ciastkolog/UTP_stm32_board/PCB/scheme.png

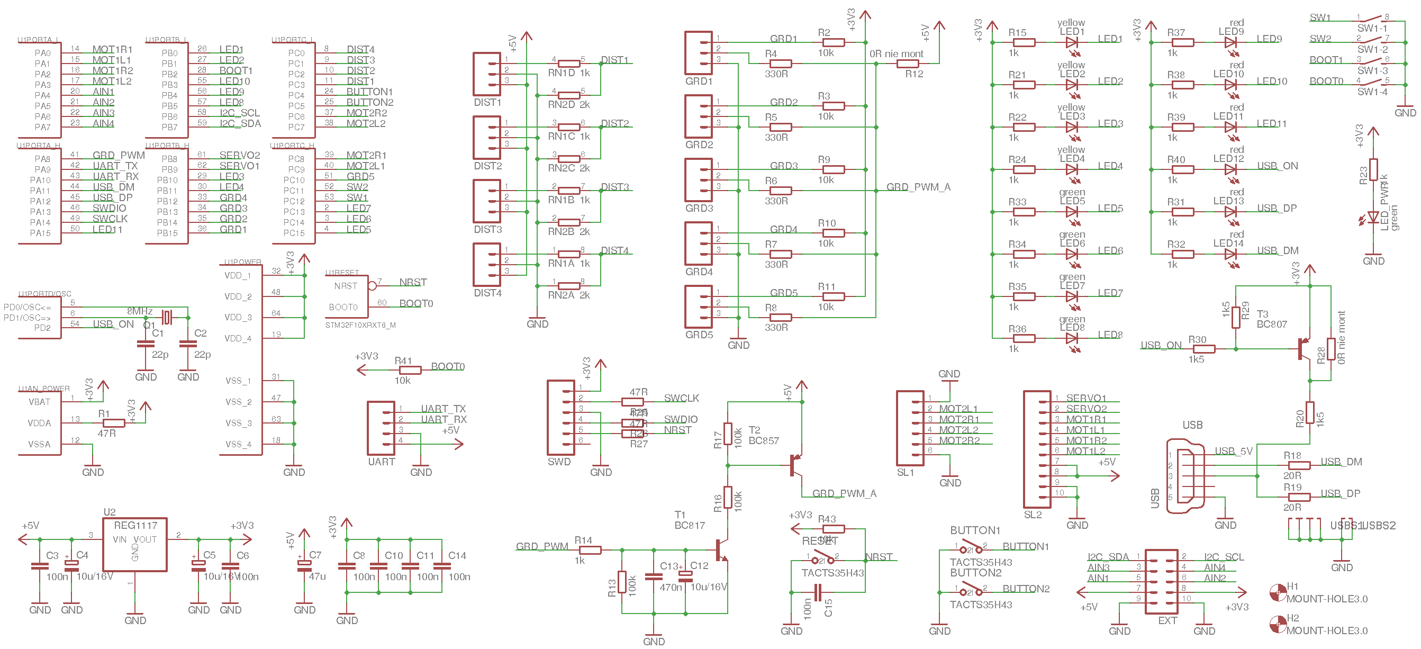
PCB/scheme.png
