ciastkolog/UTP_stm32_board/PCB/sumo_motor_5.brd

## EAGLE design PCB/sumo_motor_5.brd (2017-11-10)

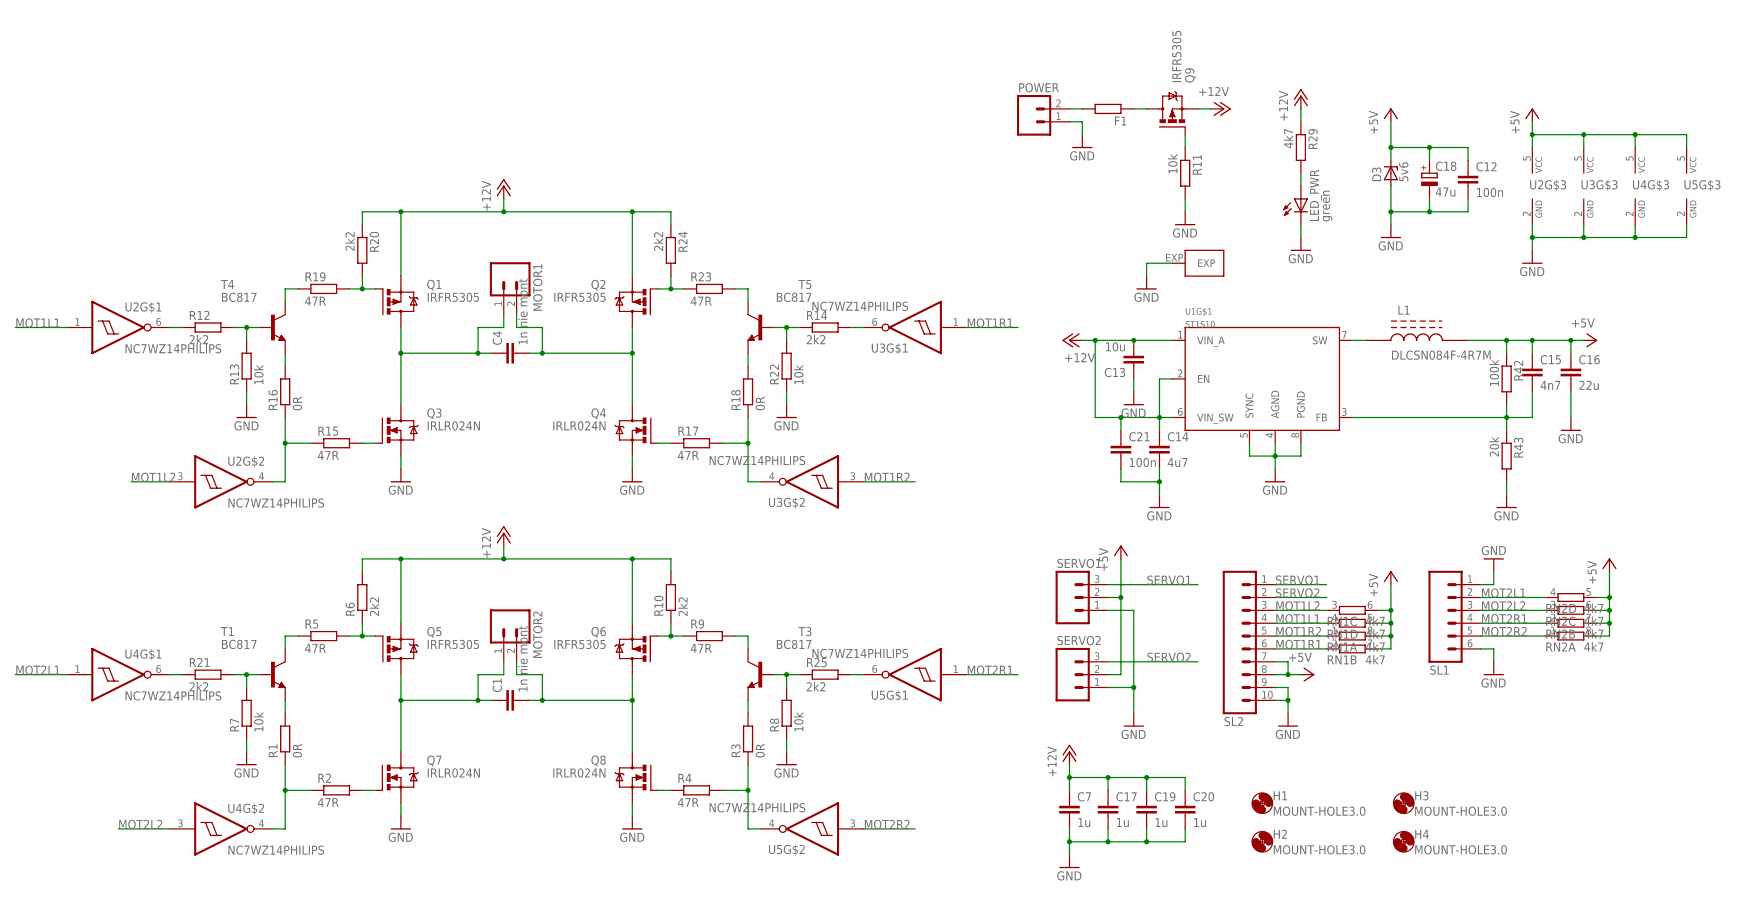
[picture p30: schematic sumo_motor_5.sch]

Parts:
C1, C4: 1n nie mont; C025-025X050
C7, C17, C19, C20: 1u; C0805
C12, C21: 100n; C0805
C13: 10u; C1206K
C14: 4u7; C0805
C15: 4n7; C0805
C16: 22u; C0805
C18: 47u; SMC_B
D3: 5v6; SMB
F1: R-EU_VMTA55; VMTA55
H1, H2, H3, H4: MOUNT-HOLE3.0; 3,0
L1: DLCSN084F-4R7M; CSN084F
LED_PWR: green; SML0805
MOTOR1, MOTOR2: M02; 02P
POWER: M02; 02P
Q1, Q2, Q5, Q6, Q9: IRFR5305; D-PAK_TO252AA
Q3, Q4, Q7, Q8: IRLR024N; D-PAK_TO252AA
R1, R3, R16, R18: 0R; R0603
R2, R4, R5, R9, R15, R17, R19, R23: 47R; R0603
R6, R10, R12, R14, R20, R21, R24, R25: 2k2; R0603
R7, R8, R11, R13, R22: 10k; R0603
R29: 4k7; R0603
R42: 100k; R0603
R43: 20k; R0603
RN1, RN2: 4k7; CAT16XXX
SERVO1, SERVO2: M03; 03P
SL1: M06; 06P
SL2: M10; 10P
T1, T3, T4, T5: BC817; SOT23-BEC
U1: ST1S10; HSOP8
U2, U3, U4, U5: NC7WZ14PHILIPS; SOT363_PHILIPS

Connections:
+5V: C12.1, C15.1, C16.1, C18.+, D3.C, L1.2, R42.1, RN1.5 (2), RN1.6 (2), RN1.7 (2), RN1.8 (2), RN2.5 (2), RN2.6 (2), RN2.7 (2), RN2.8 (2), SERVO1.2, SERVO2.2, SL2.7, SL2.8, U2.5 (VCC), U3.5 (VCC), U4.5 (VCC), U5.5 (VCC)
+12V: C7.1, C13.2, C14.1, C17.1, C19.1, C20.1, C21.1, Q1.3 (S), Q2.3 (S), Q5.3 (S), Q6.3 (S), Q9.3 (S), R6.2, R10.2, R20.1, R24.1, R29.1, U1.1 (VIN_A), U1.2 (EN), U1.6 (VIN_SW)
GND: C7.2, C12.2, C13.1, C14.2, C16.2, C17.2, C18.-, C19.2, C20.2, C21.2, D3.A, LED_PWR.C, POWER.1, Q3.3 (S), Q4.3 (S), Q7.3 (S), Q8.3 (S), R7.1, R8.1, R11.2, R13.1, R22.1, R43.2, SERVO1.1, SERVO2.1, SL1.1, SL1.6, SL2.9, SL2.10, U1.4 (AGND), U1.5 (SYNC), U1.8 (PGND), U1.EXP, U2.2 (GND), U3.2 (GND), U4.2 (GND), U5.2 (GND)
MOT1L1: RN1.4 (1), SL2.4, U2.1 (I)
MOT1L2: RN1.3 (1), SL2.3, U2.3 (I)
MOT1R1: RN1.2 (1), SL2.6, U3.1 (I)
MOT1R2: RN1.1, SL2.5, U3.3 (I)
MOT2L1: RN2.4 (1), SL1.2, U4.1 (I)
MOT2L2: RN2.3 (1), SL1.3, U4.3 (I)
MOT2R1: RN2.2 (1), SL1.4, U5.1 (I)
MOT2R2: RN2.1, SL1.5, U5.3 (I)
unnamed: R5.1, T1.C
unnamed: C1.1, MOTOR2.1, Q5.4 (D), Q7.4 (D)
unnamed: C1.2, MOTOR2.2, Q6.4 (D), Q8.4 (D)
unnamed: R19.1, T4.C
unnamed: R7.2, R21.2, T1.B
unnamed: Q5.1 (G), R5.2, R6.1
unnamed: Q6.1 (G), R9.1, R10.1
unnamed: R21.1, U4.6 (O)
unnamed: R1.2, T1.E
unnamed: R1.1, R2.1, U4.4 (O)
unnamed: Q3.1 (G), R15.2
unnamed: R16.2, T4.E
unnamed: Q7.1 (G), R2.2
unnamed: C4.1, MOTOR1.1, Q1.4 (D), Q3.4 (D)
unnamed: C4.2, MOTOR1.2, Q2.4 (D), Q4.4 (D)
unnamed: Q1.1 (G), R19.2, R20.2
unnamed: Q2.1 (G), R23.1, R24.2
unnamed: Q4.1 (G), R17.1
unnamed: R17.2, R18.1, U3.4 (O)
unnamed: R12.2, R13.2, T4.B
unnamed: R12.1, U2.6 (O)
unnamed: R18.2, T5.E
unnamed: R14.2, U3.6 (O)
unnamed: F1.2, POWER.2
unnamed: F1.1, Q9.4 (D)
unnamed: LED_PWR.A, R29.2
unnamed: Q8.1 (G), R4.1
unnamed: R3.1, R4.2, U5.4 (O)
unnamed: R3.2, T3.E
unnamed: R9.2, T3.C
unnamed: R8.2, R25.1, T3.B
unnamed: R25.2, U5.6 (O)
unnamed: L1.1, U1.7 (SW)
unnamed: C15.2, R42.2, R43.1, U1.3 (FB)
unnamed: Q9.1 (G), R11.1
unnamed: R23.2, T5.C
unnamed: R15.1, R16.1, U2.4 (O)
unnamed: R14.1, R22.2, T5.B
SERVO1: SERVO1.3, SL2.1
SERVO2: SERVO2.3, SL2.2

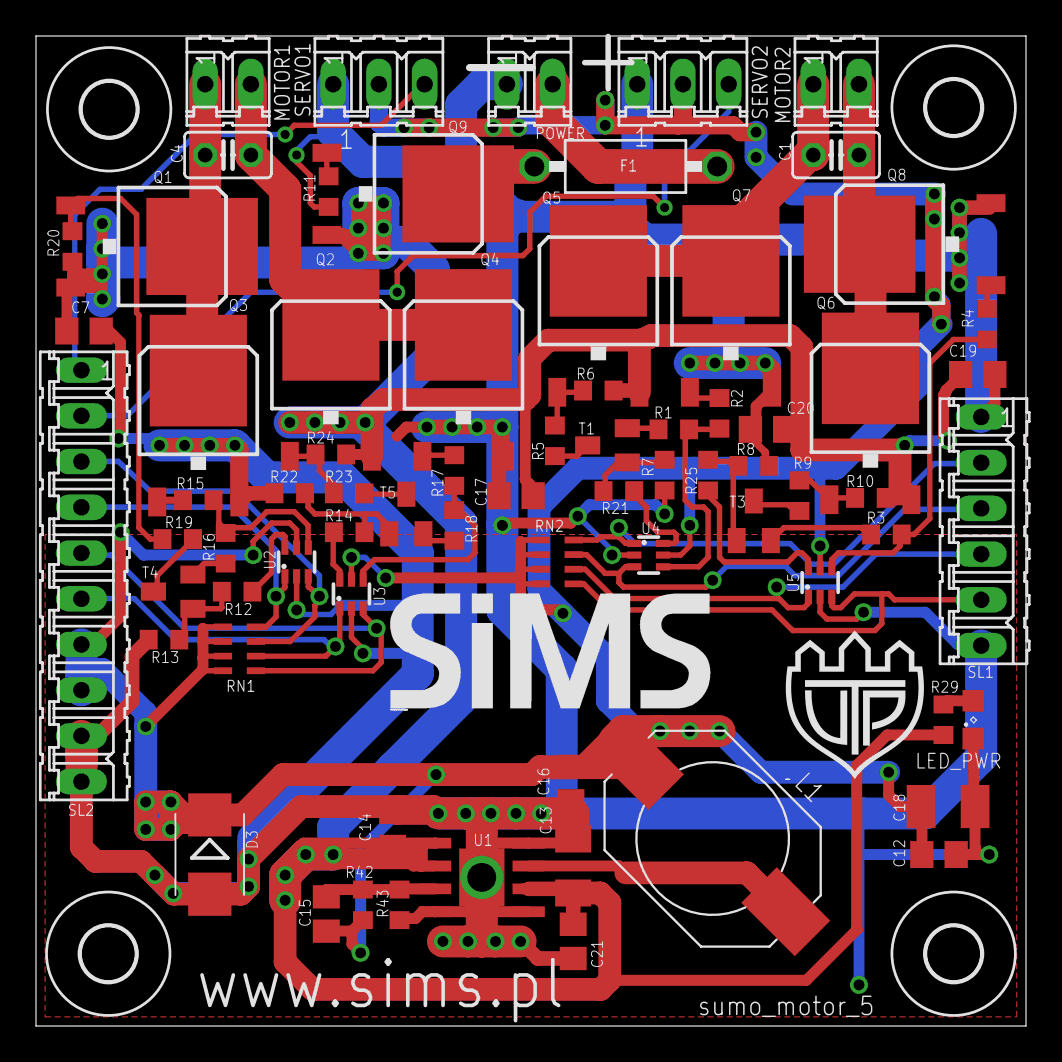
[picture p31: board sumo_motor_5.brd from above]

Board: 2 copper layers, 55.0 x 55.0 mm, 78 parts (0 on the bottom side), 51 nets.

Other parts of the board:
U$1: SIMS_07
U$2: UTP_016
