ciastkolog/UTP_stm32_board/PCB/sumo_base_5.brd

## EAGLE design PCB/sumo_base_5.brd (2017-11-10)

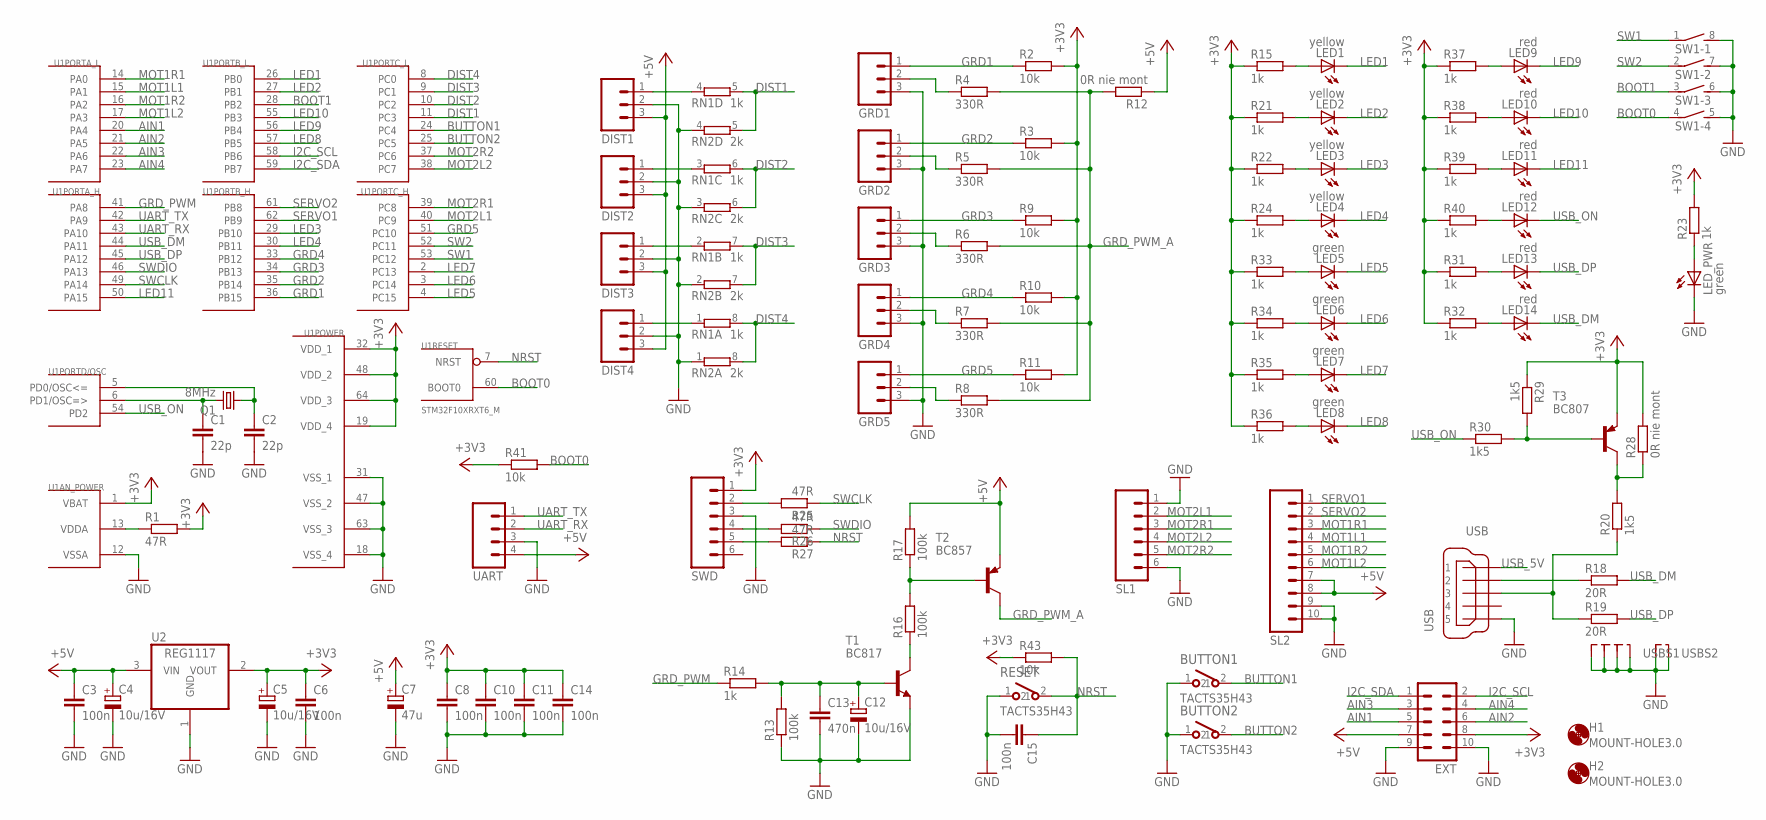
[picture p32: schematic sumo_base_5.sch]

Parts:
BUTTON1, BUTTON2: TACTS35H43
C1, C2: 22p; C0603
C3, C6, C8, C10, C11, C14, C15: 100n; C0603
C4, C5, C12: 10u/16V; SMC_A
C7: 47u; SMC_B
C13: 470n; C0603
DIST1, DIST2, DIST3, DIST4: M03; 03P
EXT: MA05-2
GRD1, GRD2, GRD3, GRD4, GRD5: M03; 03P
H1, H2: MOUNT-HOLE3.0; 3,0
LED1, LED2, LED3, LED4: yellow; SML0805
LED5, LED6, LED7, LED8: green; SML0805
LED9, LED10, LED11, LED12, LED13, LED14: red; SML0805
LED_PWR: green; SML0805
Q1: 8MHz; HC49/S
R1, R25, R26, R27: 47R; R0603
R2, R3, R9, R10, R11, R41, R43: 10k; R0603
R4, R5, R6, R7, R8: 330R; R0603
R12, R28: 0R nie mont; R0603
R13, R16, R17: 100k; R0603
R14, R15, R21, R22, R23, R24, R31, R32, R33, R34, R35, R36, R37, R38, R39, R40: 1k; R0603
R18, R19: 20R; R0603
R20, R29, R30: 1k5; R0603
RESET: TACTS35H43
RN1: 1k; CAT16XXX
RN2: 2k; CAT16XXX
SL1: M06; 06P
SL2: M10; 10P
SW1: DIP04S
SWD: M06; 06P
T1: BC817; SOT23-BEC
T2: BC857; SOT23-BEC
T3: BC807; SOT23-BEC
U1: STM32F10XRXT6_M; FP64E
U2: REG1117; SOT223
UART: M04; 04P
USB: USB; MX47346

Connections:
+3V3: C5.+, C6.1, C8.1, C10.1, C11.1, C14.1, EXT.8, R1.2, R2.2, R3.2, R9.2, R10.2, R11.2, R15.1, R21.1, R22.1, R23.2, R24.1, R28.2, R29.1, R31.1, R32.1, R33.1, R34.1, R35.1, R36.1, R37.1, R38.1, R39.1, R40.1, R41.1, R43.1, SWD.1, T3.E, U1.1 (VBAT), U1.19 (VDD_4), U1.32 (VDD_1), U1.48 (VDD_2), U1.64 (VDD_3), U2.2 (VOUT)
+5V: C3.1, C4.+, C7.+, DIST1.3, DIST2.3, DIST3.3, DIST4.3, EXT.7, R12.1, R17.2, SL2.7, SL2.8, T2.E, U2.3 (VIN), UART.4
AIN1: EXT.5, U1.20 (PA4)
AIN2: EXT.6, U1.21 (PA5)
AIN3: EXT.3, U1.22 (PA6)
AIN4: EXT.4, U1.23 (PA7)
BOOT0: R41.2, SW1.4 (1), U1.60 (BOOT0)
BOOT1: SW1.3 (1), U1.28 (PB2)
BUTTON1: BUTTON1.2, U1.24 (PC4)
BUTTON2: BUTTON2.2, U1.25 (PC5)
DIST1: RN1.5 (2), RN2.5 (2), U1.11 (PC3)
DIST2: RN1.6 (2), RN2.6 (2), U1.10 (PC2)
DIST3: RN1.7 (2), RN2.7 (2), U1.9 (PC1)
DIST4: RN1.8 (2), RN2.8 (2), U1.8 (PC0)
GND: BUTTON1.1, BUTTON2.1, C1.2, C2.2, C3.2, C4.-, C5.-, C6.2, C7.-, C8.2, C10.2, C11.2, C12.-, C13.2, C14.2, C15.2, DIST1.2, DIST2.2, DIST3.2, DIST4.2, EXT.9, EXT.10, GRD1.3, GRD2.3, GRD3.3, GRD4.3, GRD5.3, LED_PWR.C, R13.1, RESET.1, RN2.1, RN2.2 (1), RN2.3 (1), RN2.4 (1), SL1.1, SL1.6, SL2.9, SL2.10, SW1.5 (2), SW1.6 (2), SW1.7 (2), SW1.8 (2), SWD.3, T1.E, U1.12 (VSSA), U1.18 (VSS_4), U1.31 (VSS_1), U1.47 (VSS_2), U1.63 (VSS_3), U2.1 (GND), UART.3, USB.5, USB.M1 (S1), USB.M2 (S2), USB.M3 (S3), USB.M4 (S4), USB.M5 (S1), USB.M6 (S2)
GRD1: GRD1.1, R2.1, U1.36 (PB15)
GRD2: GRD2.1, R3.1, U1.35 (PB14)
GRD3: GRD3.1, R9.1, U1.34 (PB13)
GRD4: GRD4.1, R10.1, U1.33 (PB12)
GRD5: GRD5.1, R11.1, U1.51 (PC10)
GRD_PWM: R14.1, U1.41 (PA8)
GRD_PWM_A: R4.2, R5.2, R6.2, R7.2, R8.2, R12.2, T2.C
I2C_SCL: EXT.2, U1.58 (PB6)
I2C_SDA: EXT.1, U1.59 (PB7)
LED1: LED1.C, U1.26 (PB0)
LED2: LED2.C, U1.27 (PB1)
LED3: LED3.C, U1.29 (PB10)
LED4: LED4.C, U1.30 (PB11)
LED5: LED5.C, U1.4 (PC15)
LED6: LED6.C, U1.3 (PC14)
LED7: LED7.C, U1.2 (PC13)
LED8: LED8.C, U1.57 (PB5)
LED9: LED9.C, U1.56 (PB4)
LED10: LED10.C, U1.55 (PB3)
LED11: LED11.C, U1.50 (PA15)
MOT1L1: SL2.4, U1.15 (PA1)
MOT1L2: SL2.6, U1.17 (PA3)
MOT1R1: SL2.3, U1.14 (PA0)
MOT1R2: SL2.5, U1.16 (PA2)
MOT2L1: SL1.2, U1.40 (PC9)
MOT2L2: SL1.4, U1.38 (PC7)
MOT2R1: SL1.3, U1.39 (PC8)
MOT2R2: SL1.5, U1.37 (PC6)
unnamed: R29.2, R30.2, T3.B
unnamed: R20.2, R28.1, T3.C
unnamed: LED_PWR.A, R23.1
unnamed: LED12.A, R40.2
unnamed: LED13.A, R31.2
unnamed: LED14.A, R32.2
unnamed: R25.2, SWD.2
unnamed: C2.1, Q1.1, U1.5 (PD0/OSC<=)
unnamed: C1.1, Q1.2, U1.6 (PD1/OSC=>)
unnamed: R1.1, U1.13 (VDDA)
unnamed: DIST1.1, RN1.4 (1)
unnamed: GRD3.2, R6.1
unnamed: DIST3.1, RN1.2 (1)
unnamed: DIST2.1, RN1.3 (1)
unnamed: DIST4.1, RN1.1
unnamed: GRD1.2, R4.1
unnamed: GRD2.2, R5.1
unnamed: GRD4.2, R7.1
unnamed: GRD5.2, R8.1
unnamed: C12.+, C13.1, R13.2, R14.2, T1.B
unnamed: LED1.A, R15.2
unnamed: LED2.A, R21.2
unnamed: LED3.A, R22.2
unnamed: LED4.A, R24.2
unnamed: LED5.A, R33.2
unnamed: LED6.A, R34.2
unnamed: LED7.A, R35.2
unnamed: LED8.A, R36.2
unnamed: R16.1, T1.C
unnamed: R16.2, R17.1, T2.B
unnamed: R18.1, USB.2
unnamed: R19.1, R20.1, USB.3
unnamed: LED9.A, R37.2
unnamed: LED10.A, R38.2
unnamed: LED11.A, R39.2
unnamed: R26.2, SWD.4
unnamed: R27.2, SWD.5
NRST: C15.1, R27.1, R43.2, RESET.2, U1.7 (NRST)
SERVO1: SL2.1, U1.62 (PB9)
SERVO2: SL2.2, U1.61 (PB8)
SW1: SW1.1, U1.53 (PC12)
SW2: SW1.2 (1), U1.52 (PC11)
SWCLK: R25.1, U1.49 (PA14)
SWDIO: R26.1, U1.46 (PA13)
UART_RX: U1.43 (PA10), UART.2
UART_TX: U1.42 (PA9), UART.1
USB_5V: USB.1
USB_DM: LED14.C, R18.2, U1.44 (PA11)
USB_DP: LED13.C, R19.2, U1.45 (PA12)
USB_ON: LED12.C, R30.1, U1.54 (PD2)

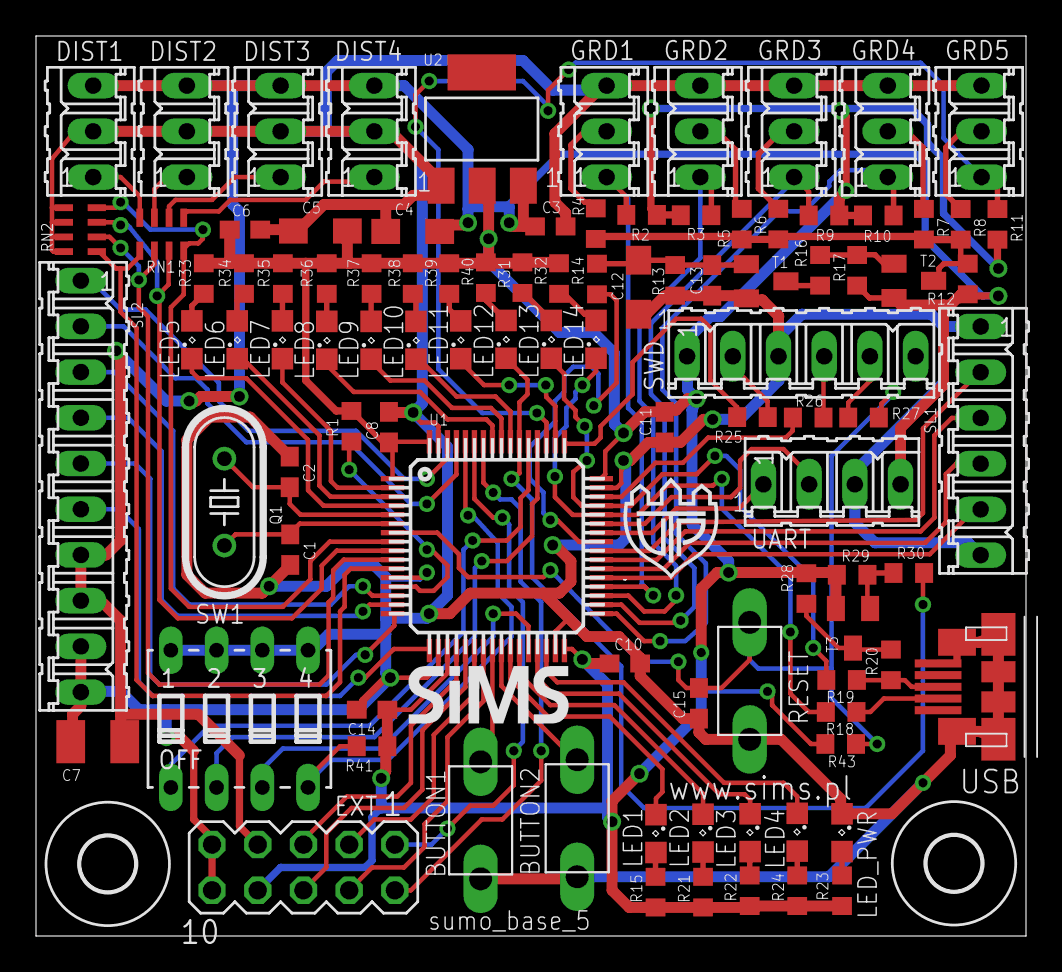
[picture p33: board sumo_base_5.brd from above]

Board: 2 copper layers, 55.0 x 50.0 mm, 102 parts (0 on the bottom side), 92 nets.

Other parts of the board:
U$1: SIMS_035
U$2: UTP_011
