ciastkolog/UTP_stm32_board/code/UTP_stm32_board/Inc/main.h

#define LED7_Pin GPIO_PIN_13
#define LED7_GPIO_Port GPIOC
#define LED6_Pin GPIO_PIN_14
#define LED6_GPIO_Port GPIOC
#define LED5_Pin GPIO_PIN_15
#define LED5_GPIO_Port GPIOC
#define BUTTON1_Pin GPIO_PIN_4
#define BUTTON1_GPIO_Port GPIOC
#define BUTTON2_Pin GPIO_PIN_5
#define BUTTON2_GPIO_Port GPIOC
#define LED1_Pin GPIO_PIN_0
#define LED1_GPIO_Port GPIOB
#define LED2_Pin GPIO_PIN_1
#define LED2_GPIO_Port GPIOB
#define SW3_Pin GPIO_PIN_2
#define SW3_GPIO_Port GPIOB
#define LED3_Pin GPIO_PIN_10
#define LED3_GPIO_Port GPIOB
#define LED4_Pin GPIO_PIN_11
#define LED4_GPIO_Port GPIOB
#define LED11_Pin GPIO_PIN_15
#define LED11_GPIO_Port GPIOA
#define SW2_Pin GPIO_PIN_11
#define SW2_GPIO_Port GPIOC
#define SW1_Pin GPIO_PIN_12
#define SW1_GPIO_Port GPIOC
#define USB_ON_Pin GPIO_PIN_2
#define USB_ON_GPIO_Port GPIOD
#define LED10_Pin GPIO_PIN_3
#define LED10_GPIO_Port GPIOB
#define LED9_Pin GPIO_PIN_4
#define LED9_GPIO_Port GPIOB
#define LED8_Pin GPIO_PIN_5
#define LED8_GPIO_Port GPIOB
