ciastkolog/UTP_stm32_board/(commit log)

2017-11-10 Add scheme and PCB project
    [sumo_base_5.brd, sumo_base_5.sch, sumo_motor_5.brd, sumo_motor_5.sch]
2017-11-10 Add materials from roboty.utp.edu.pl
