ciastkolog/UTP_stm32_board/(notices)

Notices in the files:
code/UTP_stm32_board/Inc/main.h:
COPYRIGHT(c) 2017 STMicroelectronics
(C) COPYRIGHT STMicroelectronics *****END OF FILE
